catsplosion/ece_299_clock_radio/README.md

Development repo for the ECE 299 clock-radio project.
