catsplosion/ece_299_clock_radio/kicad/schematic_all/schematic_all.kicad_pcb

## KiCad design kicad/schematic_all/schematic_all.kicad_pcb (2024-07-13)

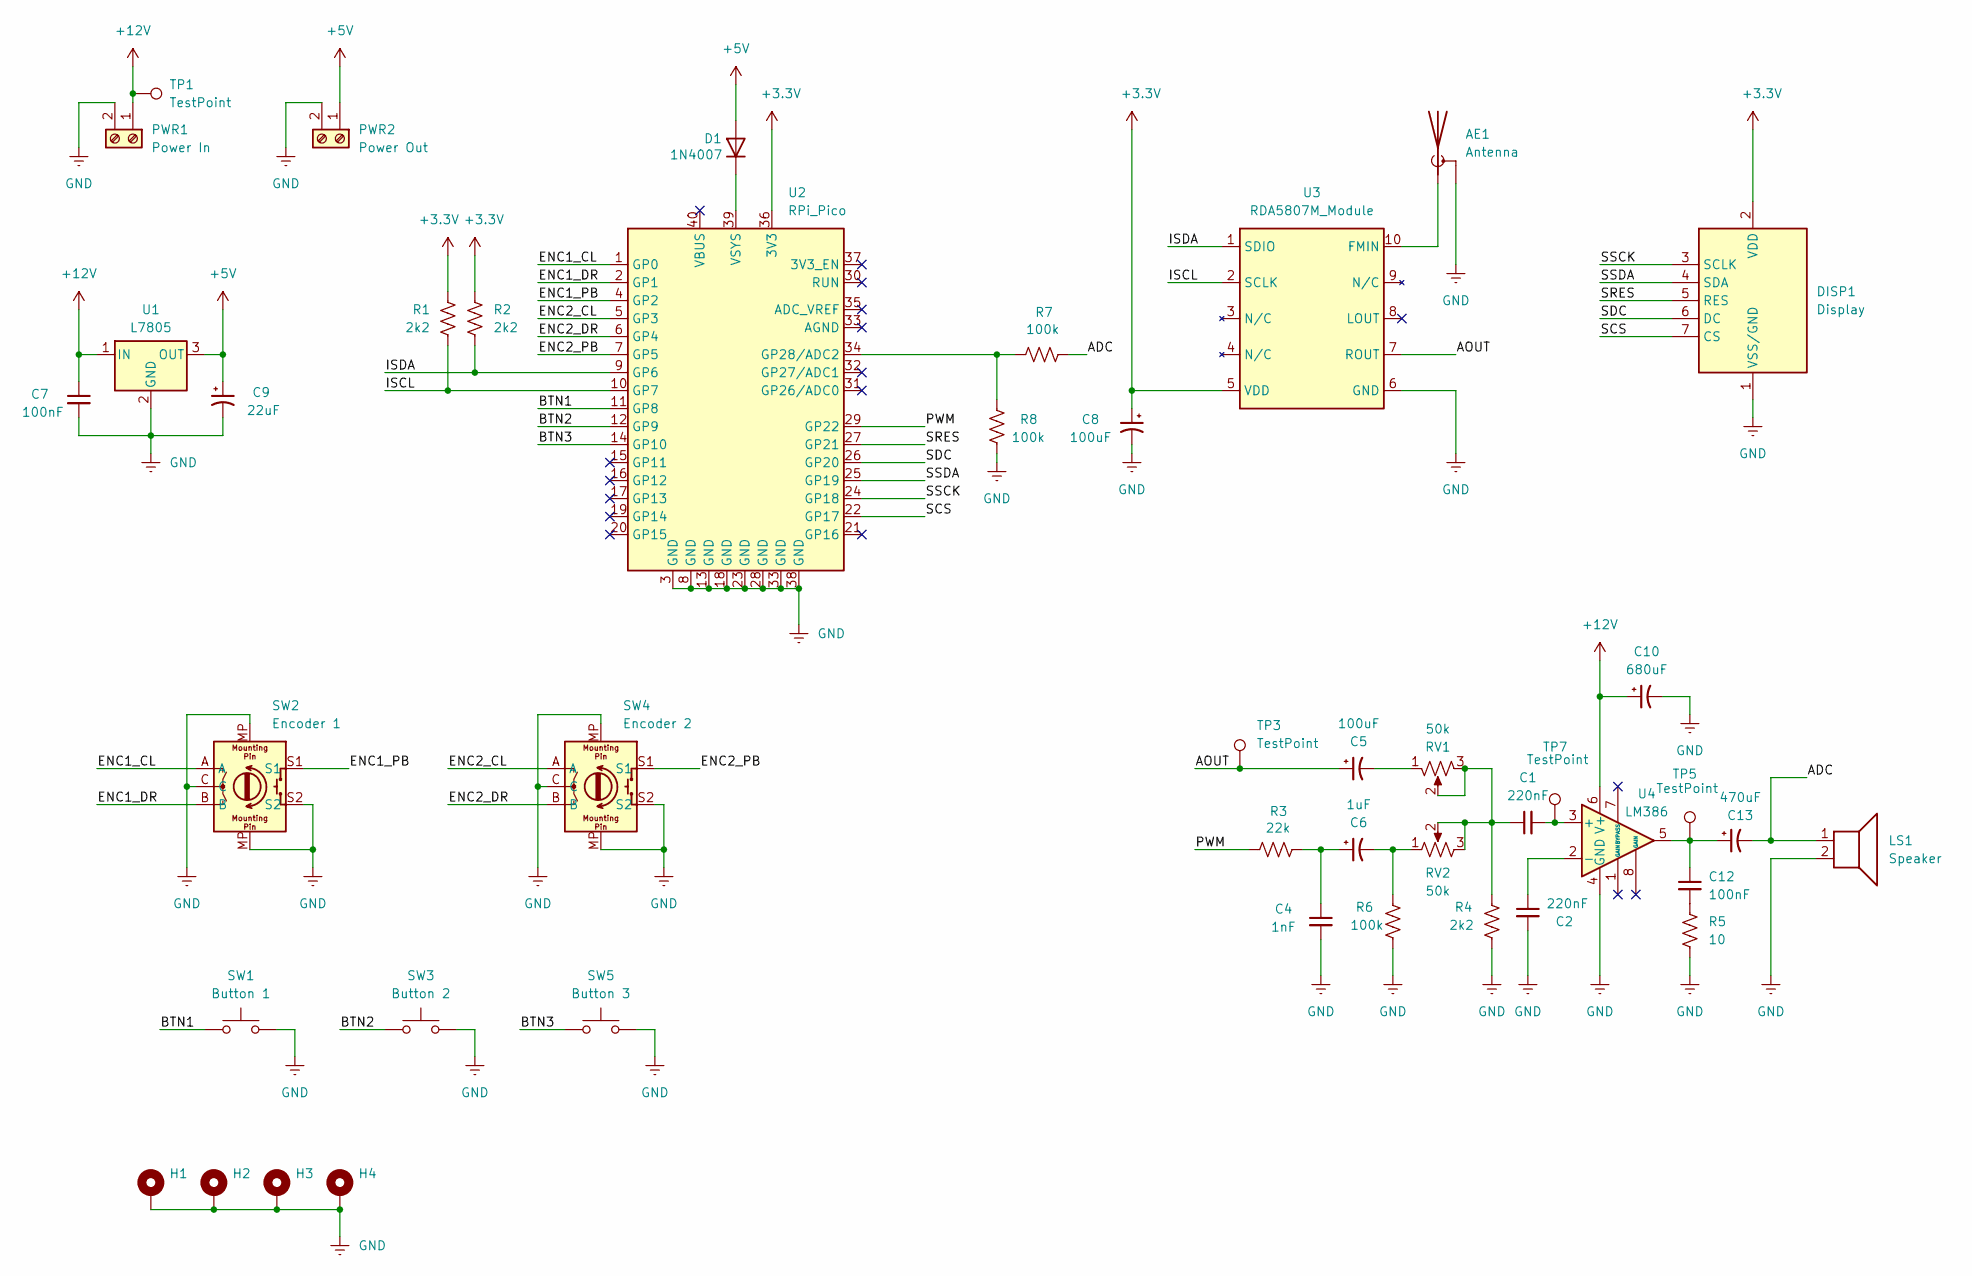
[picture p1: schematic schematic_all.kicad_sch, ECE 299 - Alarm Clock Radio]

Parts:
AE1: Antenna; TerminalBlock_Phoenix_MKDS-1,5-2_1x02_P5.00mm_Horizontal
C1, C2: 220nF; C_Disc_D5.0mm_W2.5mm_P5.00mm
C4: 1nF; C_Disc_D5.0mm_W2.5mm_P5.00mm
C5, C8: 100uF; CP_Radial_D5.0mm_P2.00mm
C6: 1uF; CP_Radial_D5.0mm_P2.00mm
C7, C12: 100nF; C_Disc_D3.0mm_W2.0mm_P2.50mm
C9: 22uF; CP_Radial_D5.0mm_P2.00mm
C10: 680uF; CP_Radial_D8.0mm_P3.50mm
C13: 470uF; CP_Radial_D8.0mm_P3.50mm
D1: 1N4007; D_DO-41_SOD81_P10.16mm_Horizontal
DISP1: Display; TerminalBlock_Phoenix_MKDS-1,5-7_1x07_P5.00mm_Horizontal
H1, H2, H3, H4: MountingHole_3.2mm_M3_Pad
LS1: Speaker; TerminalBlock_Phoenix_MKDS-1,5-2_1x02_P5.00mm_Horizontal
PWR1: Power In; TerminalBlock_Phoenix_MKDS-1,5-2_1x02_P5.00mm_Horizontal
PWR2: Power Out; PinHeader_1x02_P2.54mm_Vertical
R1, R2, R4: 2k2; R_Axial_DIN0207_L6.3mm_D2.5mm_P10.16mm_Horizontal
R3: 22k; R_Axial_DIN0207_L6.3mm_D2.5mm_P10.16mm_Horizontal
R5: 10; R_Axial_DIN0207_L6.3mm_D2.5mm_P10.16mm_Horizontal
R6, R7, R8: 100k; R_Axial_DIN0207_L6.3mm_D2.5mm_P10.16mm_Horizontal
RV1, RV2: 50k; Bourns_PTV09_Horiz
SW1: Button 1; TerminalBlock_Phoenix_MKDS-1,5-2_1x02_P5.00mm_Horizontal
SW2: Encoder 1; TerminalBlock_Phoenix_MKDS-1,5-4_1x04_P5.00mm_Horizontal
SW3: Button 2; TerminalBlock_Phoenix_MKDS-1,5-2_1x02_P5.00mm_Horizontal
SW4: Encoder 2; TerminalBlock_Phoenix_MKDS-1,5-4_1x04_P5.00mm_Horizontal
SW5: Button 3; TerminalBlock_Phoenix_MKDS-1,5-2_1x02_P5.00mm_Horizontal
TP1, TP3, TP5, TP7: TestPoint; PinHeader_1x01_P2.54mm_Vertical
U1: L7805; TO-220-3_Vertical
U2: RPi_Pico; RPi_Pico_TH
U3: RDA5807M_Module; RDA5807M_Module_TH
U4: LM386; DIP-8_W7.62mm_Socket

Connections:
+3.3V: C8.1, DISP1.2 (VDD), R1.1, R2.1, U2.36 (3V3), U3.5 (VDD)
+5V: C9.1, D1.2 (A), PWR2.1, U1.3 (OUT)
+12V: C7.1, C10.1, PWR1.1, TP1.1, U1.1 (IN), U4.6 (V+)
/ADC: C13.2, LS1.1, R7.2
/AOUT: C5.1, TP3.1, U3.7 (ROUT)
/BTN1: SW1.1, U2.11 (GP8)
/BTN2: SW3.1, U2.12 (GP9)
/BTN3: SW5.1, U2.14 (GP10)
/ENC1_CL: SW2.A, U2.1 (GP0)
/ENC1_DR: SW2.B, U2.2 (GP1)
/ENC1_PB: SW2.S1, U2.4 (GP2)
/ENC2_CL: SW4.A, U2.5 (GP3)
/ENC2_DR: SW4.B, U2.6 (GP4)
/ENC2_PB: SW4.S1, U2.7 (GP5)
/ISCL: R1.2, U2.10 (GP7), U3.2 (SCLK)
/ISDA: R2.2, U2.9 (GP6), U3.1 (SDIO)
/PWM: R3.2, U2.29 (GP22)
/SCS: DISP1.7 (CS), U2.22 (GP17)
/SDC: DISP1.6 (DC), U2.26 (GP20)
/SRES: DISP1.5 (RES), U2.27 (GP21)
/SSCK: DISP1.3 (SCLK), U2.24 (GP18)
/SSDA: DISP1.4 (SDA), U2.25 (GP19)
GND: AE1.2 (Shield), C2.2, C4.2, C7.2, C8.2, C9.2, C10.2, DISP1.1 (VSS/GND), H1.1, H2.1, H3.1, H4.1, LS1.2, PWR1.2, PWR2.2, R4.2, R5.2, R6.2, R8.1, RV1.4, RV1.5, RV2.4, RV2.5, SW1.2, SW2.C, SW2.MP, SW2.S2, SW3.2, SW4.C, SW4.MP, SW4.S2, SW5.2, U1.2 (GND), U2.3 (GND), U2.8 (GND), U2.13 (GND), U2.18 (GND), U2.23 (GND), U2.28 (GND), U2.33 (GND), U2.38 (GND), U3.6 (GND), U4.4 (GND)
unnamed: AE1.1 (A), U3.10 (FMIN)
unnamed: C1.1, R4.1, RV1.2, RV1.3, RV2.2, RV2.3
unnamed: C4.1, C6.1, R3.1
unnamed: C5.2, RV1.1
unnamed: C6.2, R6.1, RV2.1
unnamed: C12.1, C13.1, TP5.1, U4.5
unnamed: C12.2, R5.1
unnamed: D1.1 (K), U2.39 (VSYS)
unnamed: R7.1, R8.2, U2.34 (GP28/ADC2)
unnamed: C1.2, TP7.1, U4.3 (+)
unnamed: C2.1, U4.2 (-)

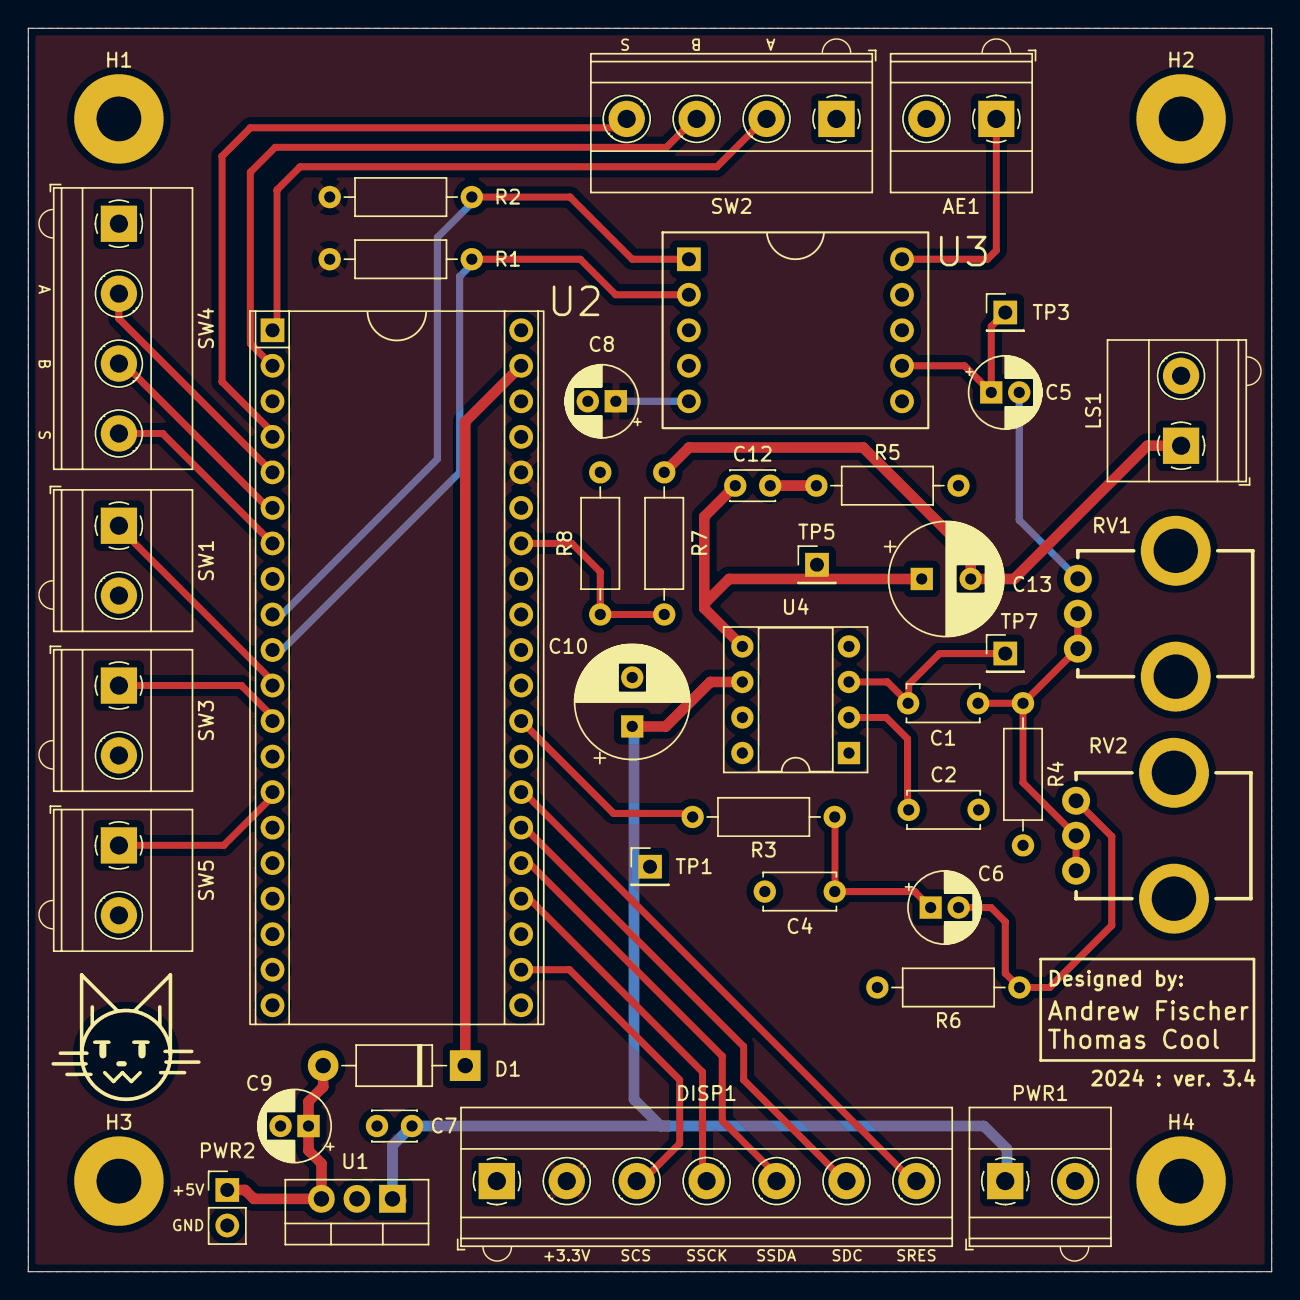
[picture p2: board schematic_all.kicad_pcb from above]

Board: 2 copper layers, 88.9 x 88.9 mm, 44 parts (0 on the bottom side), 34 nets.
