catsplosion/ece_299_clock_radio/(commit log)

2024-07-01 add kicad project
    [schematic_all.kicad_pcb, schematic_all.kicad_sch]
2024-07-02 schematic v0.1
    [schematic_all.kicad_pcb, schematic_all.kicad_sch]
2024-07-02 schematic v0.2
    [schematic_all.kicad_pcb, schematic_all.kicad_sch]
2024-07-02 fix bug with mono flag
    [rda5807.py]
2024-07-02 fix incorrect integer representation
    [rda5807.py]
2024-07-03 Made some minor changes to the schmatic (Changed PWM pin, filtering capacitor footprints and values), and made some progress on the layout & design of the PCB
    [schematic_all.kicad_pcb]
2024-07-03 Fixed small schematic save error
    [schematic_all.kicad_sch]
2024-07-03 Minor change to Power In placement, and added a corresponding track to VSYS
    [schematic_all.kicad_pcb]
2024-07-03 Added files via upload
    Finished all traces and further organized hardware.
    [schematic_all.kicad_pcb, schematic_all.kicad_sch]
2024-07-03 move uploaded files to correct directory
    [schematic_all.kicad_pcb, schematic_all.kicad_sch]
2024-07-04 Added 12V supply + linear regulator to step-down to 5V
    [schematic_all.kicad_pcb, schematic_all.kicad_sch]
2024-07-04 Replaced jack with a terminal block
    [schematic_all.kicad_pcb, schematic_all.kicad_sch]
2024-07-04 fixes and cleanup of schematic
    added in extra capacitors for linear regulator
    cleaned up traces and aligned components
    [schematic_all.kicad_pcb, schematic_all.kicad_sch]
2024-07-04 flip SPI and power traces
    [schematic_all.kicad_pcb, schematic_all.kicad_sch]
2024-07-04 Minor changes
    [schematic_all.kicad_sch]
2024-07-04 Minor changes & Added additional testpoints
    [schematic_all.kicad_pcb, schematic_all.kicad_sch]
2024-07-05 adjustments on test points and ink
    move speaker test point to before capacitor
    increase size of designed by text
    [schematic_all.kicad_pcb, schematic_all.kicad_sch]
2024-07-05 fixes and silkscreen adjustment
    remove errant trace rectangle
    shift hidden silkscreen labels
    [schematic_all.kicad_pcb]
2024-07-05 full board check
    replace incorrect radial cap with disc
    change capacitor values around amp
    add jack labels
    reground pot chassis
    tweak positions
    [schematic_all.kicad_pcb, schematic_all.kicad_sch]
2024-07-05 Fixed U3 Pad 5 3.3V connection
    [schematic_all.kicad_pcb]
2024-07-05 Isolated C8 and U3 pin 5 track
    [schematic_all.kicad_pcb]
2024-07-05 unpolarize amp coupling capacitors
    [schematic_all.kicad_pcb, schematic_all.kicad_sch]
2024-07-06 remove fill zone around U3 pin 5
    [schematic_all.kicad_pcb]
2024-07-13 fix pico power issues
    swap regulator caps to match L4941 spec
    add +5V pinout
    add diode to prevent backfeeding from pico
    [schematic_all.kicad_pcb, schematic_all.kicad_sch]
2024-07-13 add trace and jumper between radio output and pico ADC
    [schematic_all.kicad_pcb, schematic_all.kicad_sch]
2024-07-13 replace ADC jumper with voltage divider
    [schematic_all.kicad_pcb, schematic_all.kicad_sch]
2024-07-13 move ADC from after C5 to after C13
    [schematic_all.kicad_pcb, schematic_all.kicad_sch]
2024-07-13 adjust ACD voltage divider ratio
    [schematic_all.kicad_sch]
2024-07-22 Addded display class, and made minor changes & fixes to clockstate.py and boot.py
    [Display.py, MenuSystem.py, boot.py, clock_state.py, push_button.py, rotary_encoder.py]
2024-07-22 fix push button inconsistency issue
    modify push button algorithm to use a cosistency check method
    remove delay parameter
    [push_button.py]
2024-07-23 Bug fixes & features to boot.py, Menusystem.py, clockstate.py, display.py
    [Display.py, MenuSystem.py, boot.py, clock_state.py, push_button.py, rotary_encoder.py]
2024-07-23 cleanup and fix identical back methods
    move identical back functionality to superclass and fix bug when parent
    is unset
    [MenuSystem.py]
2024-07-23 add roller menu functionality for volume controls
    also fix bug with unbounded radio_volume attribute in state
    and fix bug with incorrect tuple conversion in set_alarm
    [MenuSystem.py, boot.py, clock_state.py]
2024-07-23 add snooze functionality on user input
    also fix incorrect 12hr clock string generation
    and fix bug with snooze times where alarm cannot be re-triggered between 55-60 seconds
    [MenuSystem.py, clock_state.py]
2024-07-24 ADC & FFT Testing
2024-07-25 Version 1 of the ADC -> FFT code
2024-07-25 add clock view and snooze features
    add clock view
    add led toggle menu item
    add snooze menu item
    fix bug when setting snooze delay
    add clock view reset timer
    [MenuSystem.py, boot.py, clock_state.py]
2024-07-26 Added logic for leds
2024-07-27 Almost complete integration of ADC_Testing -> Leds_handler
2024-07-29 fix bug with rotary encoder hogging all the interrupts
    [rotary_encoder.py]
2024-07-29 add temperature display
2024-07-29 Fixed LEDS, small additions and bug fixes
    [Leds_Handler.py, MenuSystem.py, boot.py]
2024-07-31 add in remaining features and fix PWM bugs
    [MenuSystem.py, boot.py, clock_state.py]
2024-08-02 various fixes for presentation
    move boot.py to main.py as boot.py file use was incorrect
    add icons for volume, mute, and signal strength
    add bad hack to get LED PWM to shut off
    add seek mode for radio frequency
    add display name for the various parameters
    offset volume diplay so it is 1-16
    change alarm volume to 1-16
    add signal strength display
    reduce encoder timeout
    [Display.py, Leds_Handler.py, MenuSystem.py, clock_state.py, main.py, rotary_encoder.py]
